xupt-glf/STM32-WiFi-SHSD/PCB/WiFi智能家居.pdf

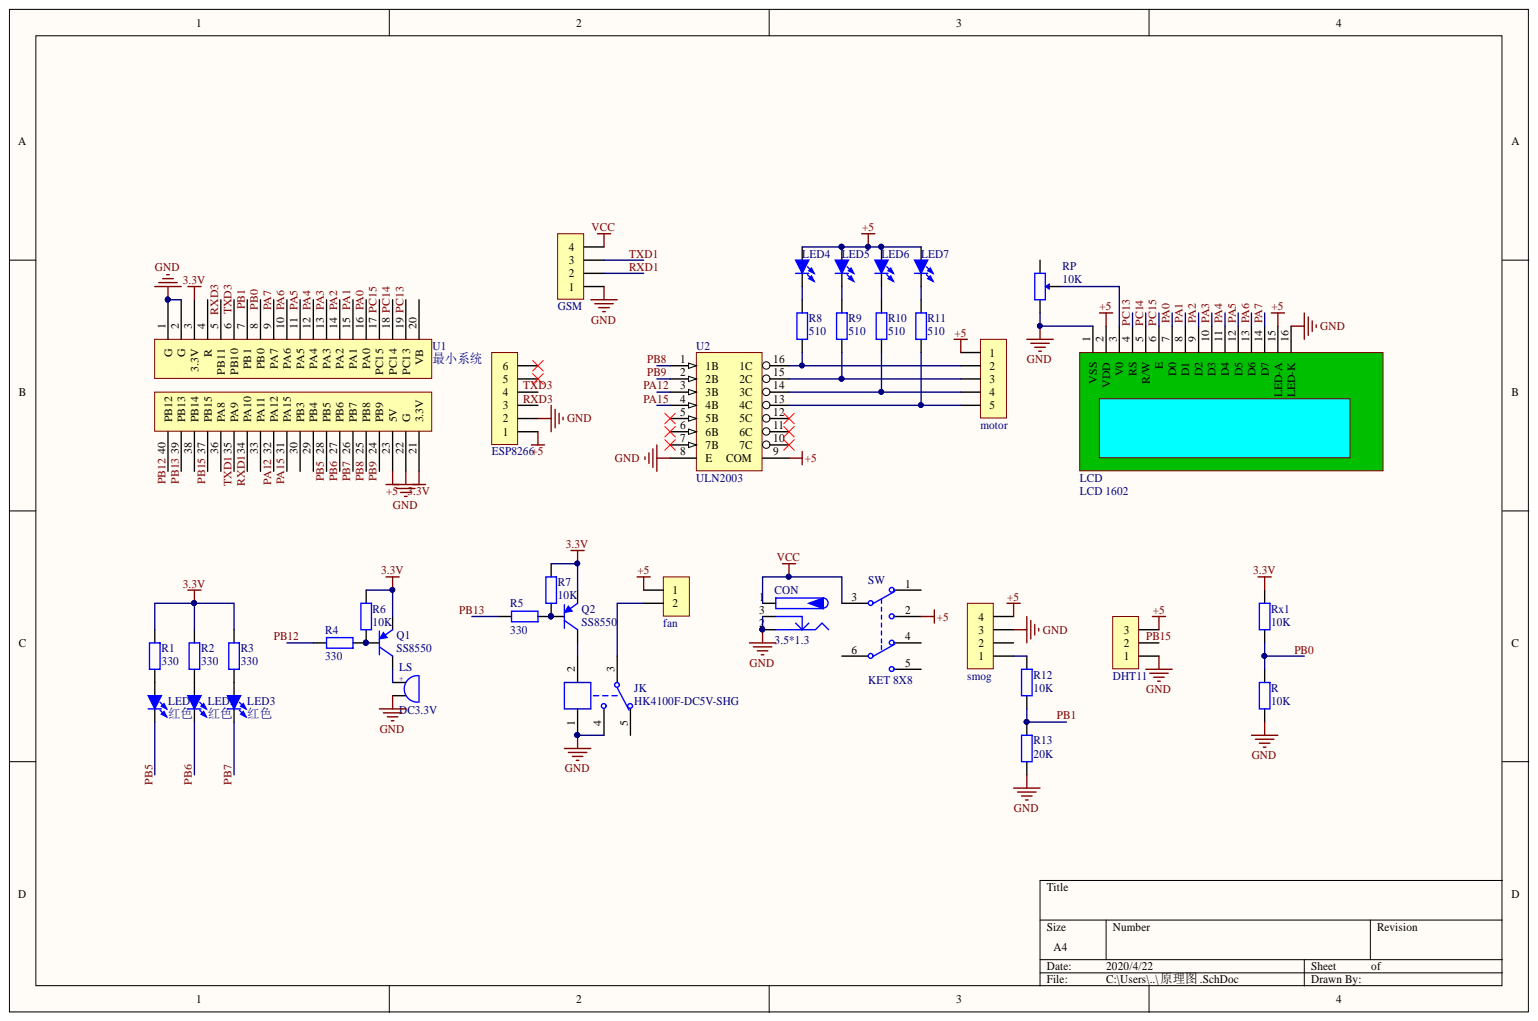
[picture p7: page 1]

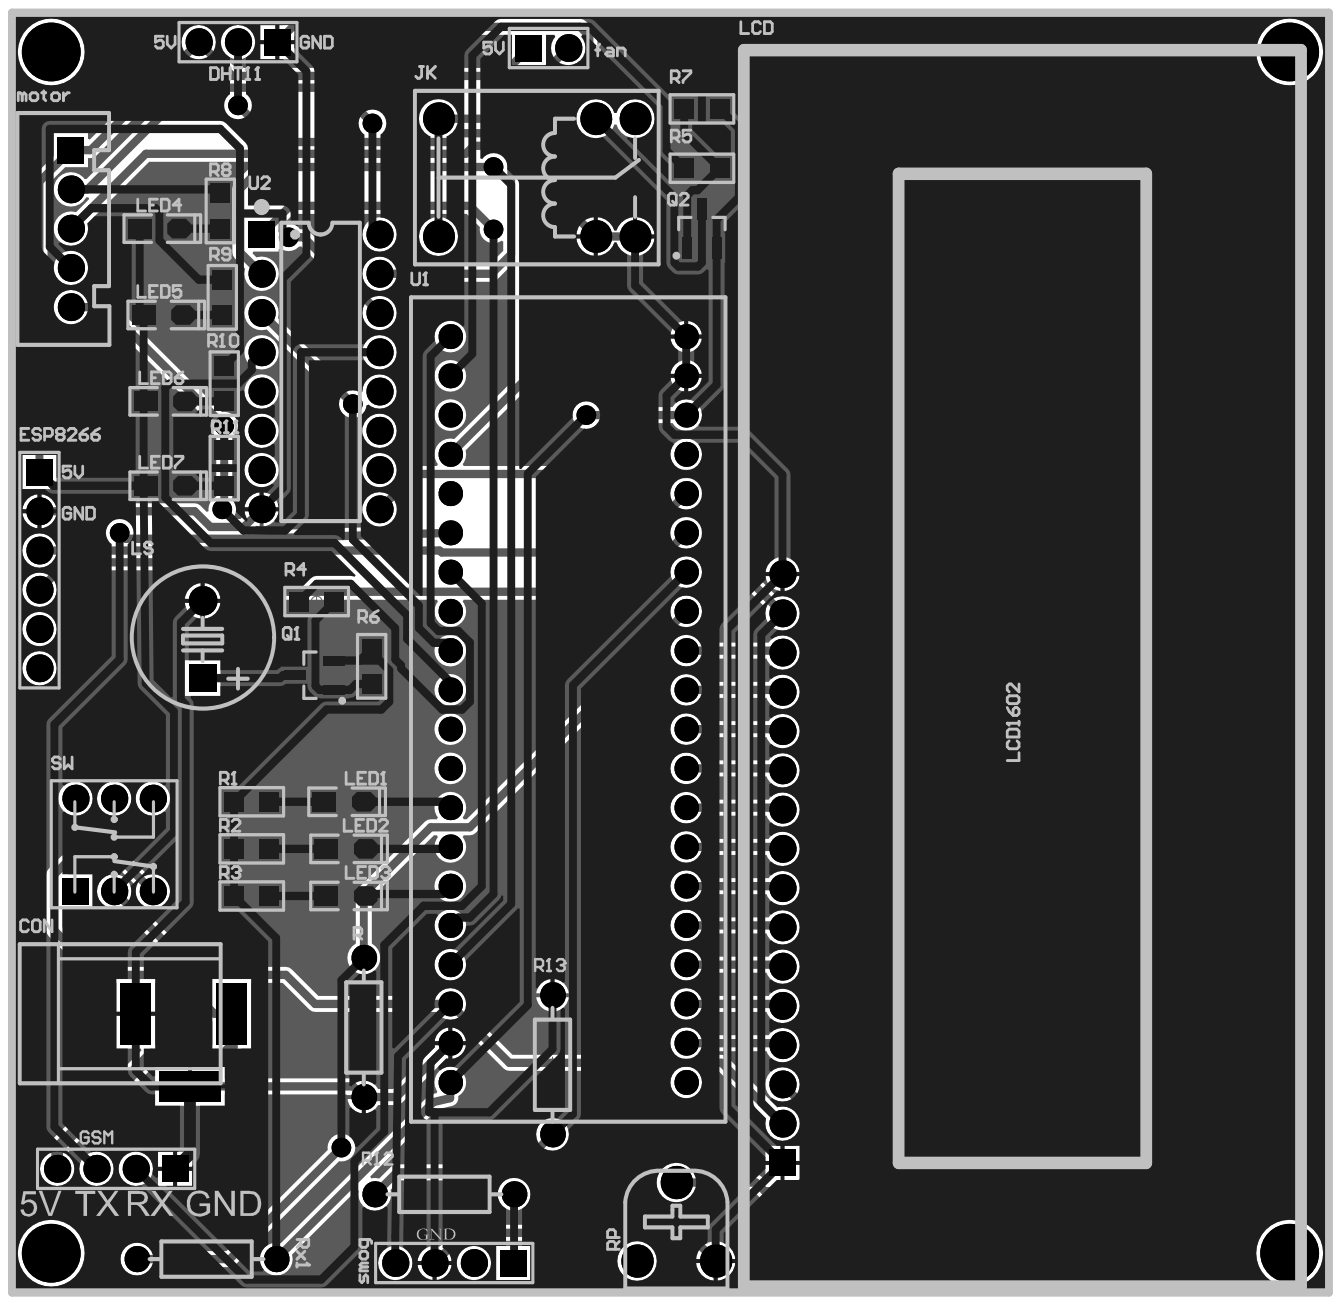
[picture p8: page 2]

Comment | Description | Designator | Footprint | LibRef | Quantity
3.5*1.3 | 低压电源接口 | CON | DC-005 | P-DC | 1
HDR-1X3 | 3P接插件 | DHT11 | HDR2.54-M-LI-3P | Header 3 | 1
HDR-1X6 | 6P接插件 | ESP8266 | HDR2.54-M-LI-6P | Header 6 | 1
HDR-1X2 | 2P接插件 | fan | HDR2.54-LI-2P | Header 2 | 1
HDR-1X4 | 4P接插件 | GSM | HDR2.54-LI-4P | Header 4 | 1
HK4100F-DC5V-SHG | 一组转换 | JK | HK4100F | HK4100F | 1
LCD 1602 | LCD 1602 | LCD | LCD-1602 | LCD 1602 | 1
红色 | 贴片LED | LED1, LED2, LED3 | LED 0805G | LED-SMD | 3
| 贴片LED | LED4, LED5, LED6, LED7 | LED 0805G | LED-SMD | 4
DC3.3V | 蜂鸣器 | LS | BEEP 5x9x5.5 | BEEP | 1
HDR-1X5 | 5P接插件 | motor | XH2.54-LI-5P | Header 5 | 1
SS8550 | 高频放大 -PNP型 | Q1, Q2 | SOT23-3M | 8550-SMD | 2
330 | 贴片电阻 | R1, R2, R3, R4, R5 | R 0805_M | R | 5
10K | 贴片电阻 | R6, R7 | R 0805_M | R | 2
510 | 贴片电阻 | R8, R9, R10, R11 | R 0805_M | R | 4
20K | 直插色环电阻 | R13 | RS 1/4W | R-CRR | 1
10K | 直插色环电阻 | R, R12, Rx1 | RS 1/4W | R-CRR | 3
10K | 插件单联电位器 | RP | RM065 | RP-ID | 1
HDR-1X4 | 4P接插件 | smog | HDR2.54-M-LI-4P | Header 4 | 1
KET 8X8 | 8*8自锁开关 | SW | KFT DIP-8X8 | KET 8X8 | 1
最小系统 | | U1 | MINI | c8t6最小系统 | 1
ULN2003 | 达林顿驱动芯片 | U2 | DIP16-300 | ULN2003-2 | 1
