xupt-glf/STM32-WiFi-SHSD/(list of files, drawings)

Other design files:
PCB/WiFi智能家居.PrjPCB
PCB/原理图.SchDoc
