xupt-glf/STM32-WiFi-SHSD/code/HARDWARE/ADC/adc.h

#ifndef __ADC_H
#define __ADC_H	
#include "sys.h"


void Adc_Init(void);
u16  Get_Adc(u8 ch); 
u16 Get_Adc_Average(u8 ch,u8 times); 
u16 Get_Adc_Average1(u8 ch1,u8 times);
u16 Get_Adc1(u8 ch1);
 
#endif 
